sprucegum/aciduino/v2/hardware/HugoEscalpelo-3DCase-1.3inOLED-ESP32DevKitV1/img/12-X-12MM-X-7.5MM-PUSH-BUTTON.jpg

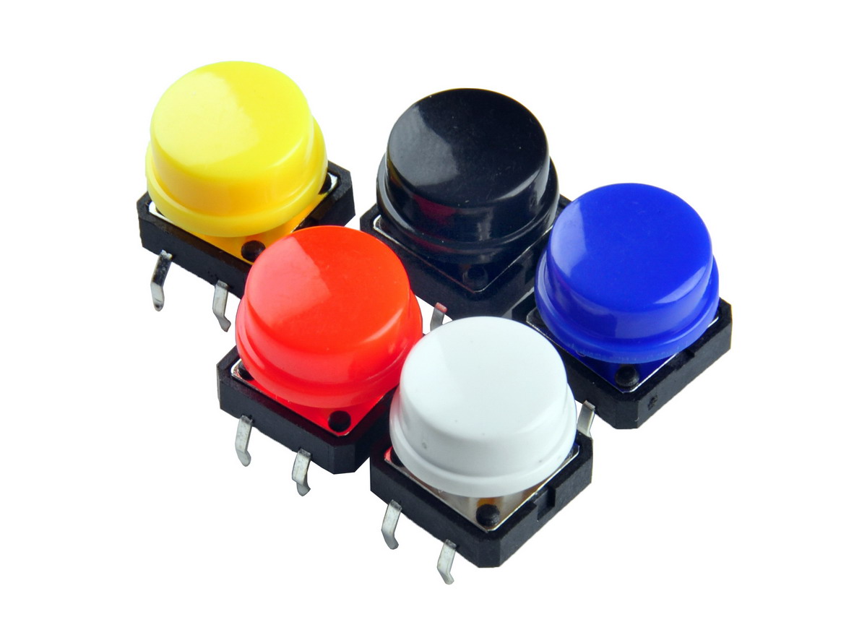
v2/hardware/HugoEscalpelo-3DCase-1.3inOLED-ESP32DevKitV1/img/12-X-12MM-X-7.5MM-PUSH-BUTTON.jpg
