sprucegum/aciduino/Renderings/---beeeeeetssss---.png

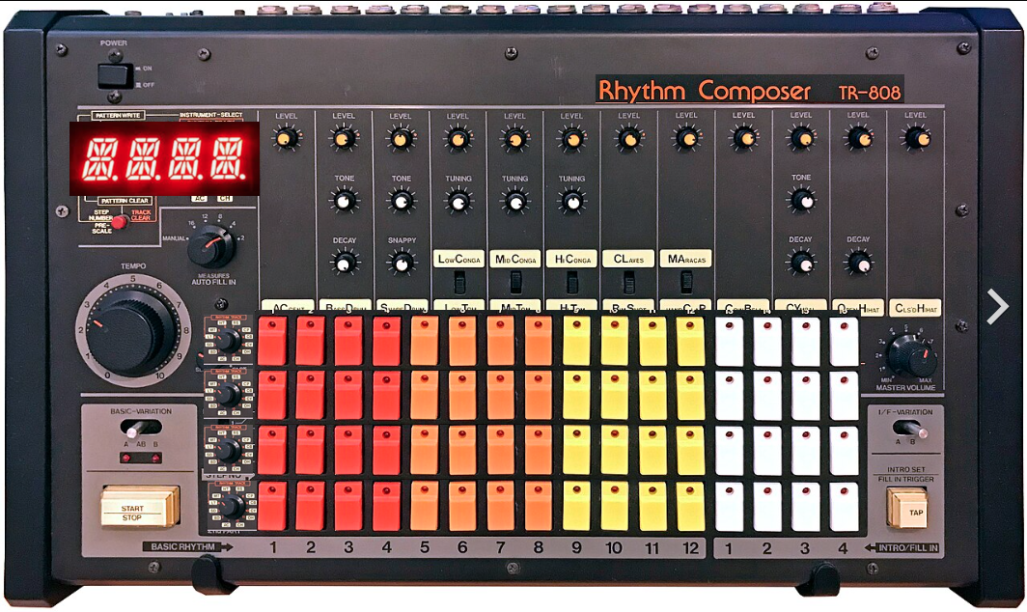
Renderings/---beeeeeetssss---.png
