sprucegum/aciduino/Renderings/DALL·E 2024-05-17 13.15.50 - A detailed diagram representing the structure and function of the AciduinoV2 project files. The diagram should include the following hierarchy and des.webp

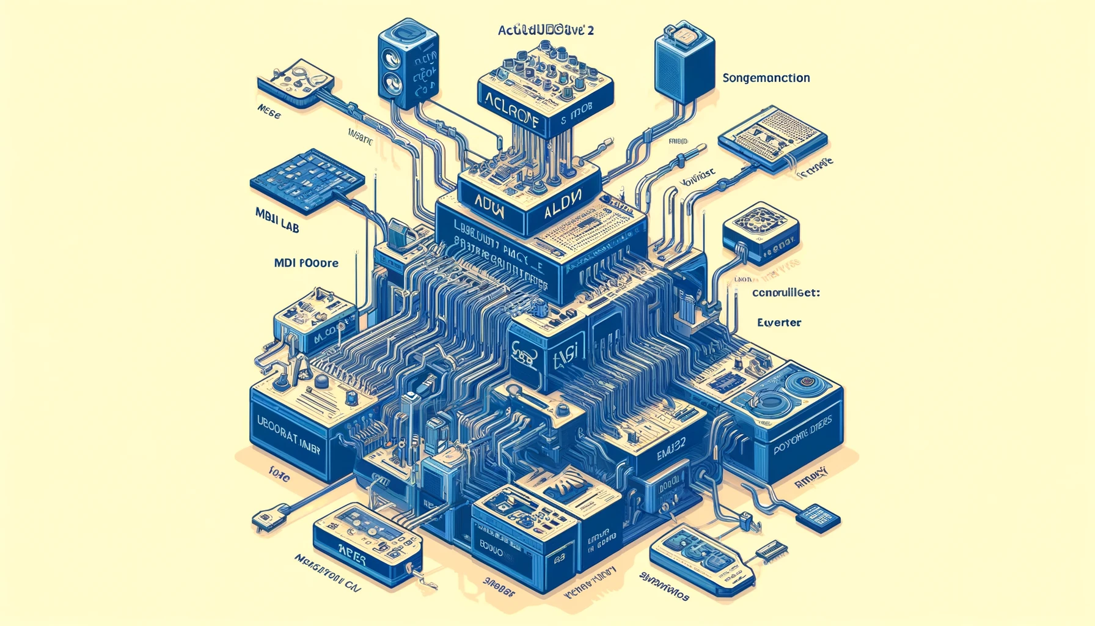
Renderings/DALL·E 2024-05-17 13.15.50 - A detailed diagram representing the structure and function of the AciduinoV2 project files. The diagram should include the following hierarchy and des.webp
