sprucegum/aciduino/Renderings/DALL·E 2024-05-17 13.17.37 - A detailed diagram representing the structure and function of the AciduinoV2 project files. The diagram should include clear, readable labels with the.webp

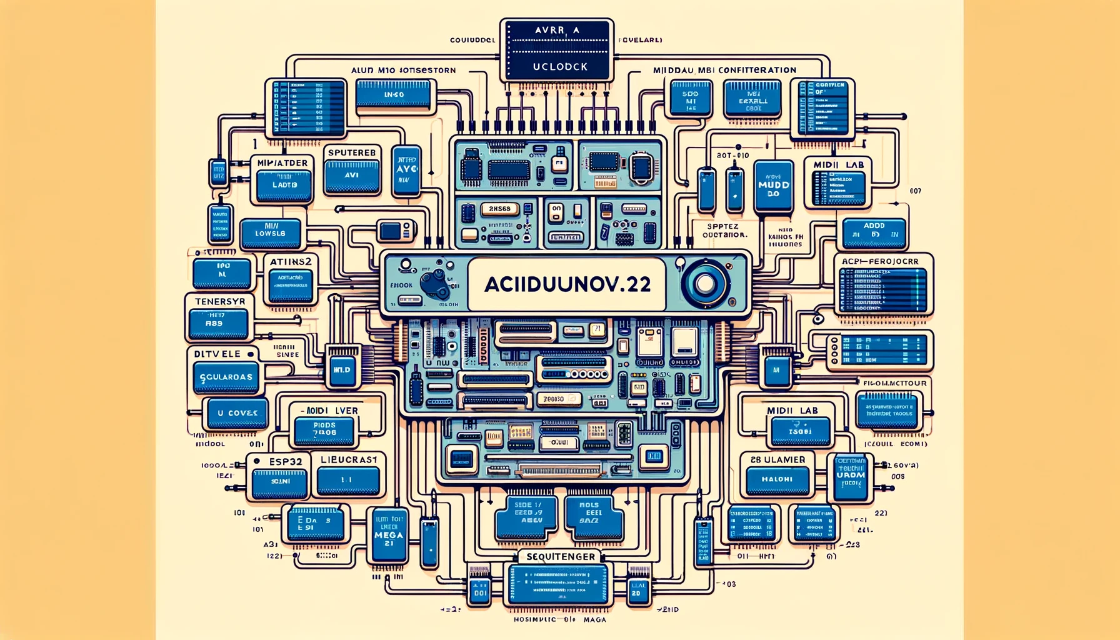
Renderings/DALL·E 2024-05-17 13.17.37 - A detailed diagram representing the structure and function of the AciduinoV2 project files. The diagram should include clear, readable labels with the.webp
