sprucegum/aciduino/Renderings/DALL·E 2024-05-17 13.19.00 - A clear and detailed diagram representing the structure and function of the AciduinoV2 project files. The diagram should include easily readable label.webp

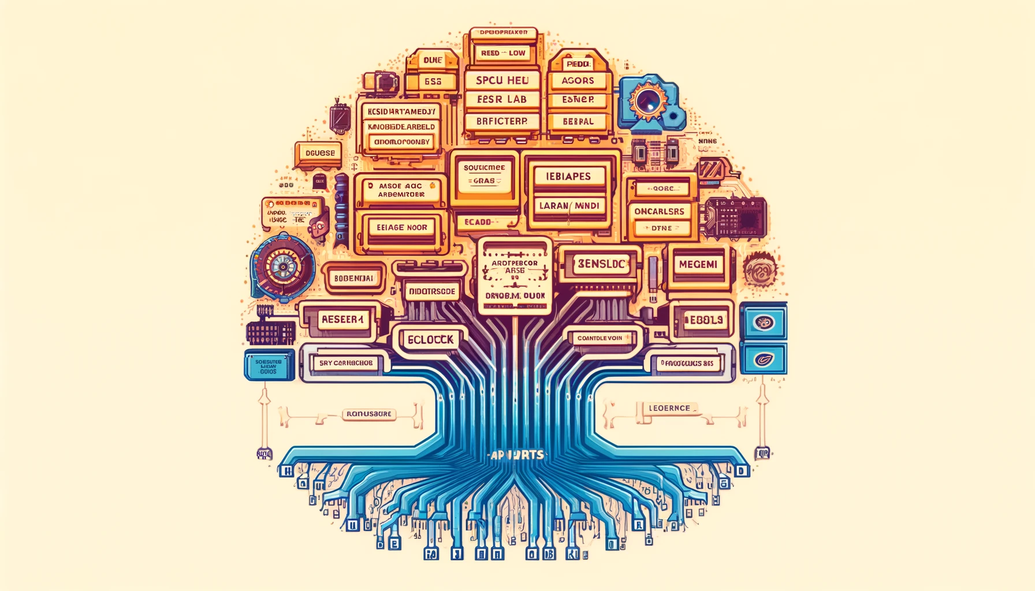
Renderings/DALL·E 2024-05-17 13.19.00 - A clear and detailed diagram representing the structure and function of the AciduinoV2 project files. The diagram should include easily readable label.webp
