sprucegum/aciduino/Renderings/DALL·E 2024-05-17 13.24.34 - A clear and detailed diagram representing the structure and function of the AciduinoV2 project files, with labels written legibly in English. The diag.webp

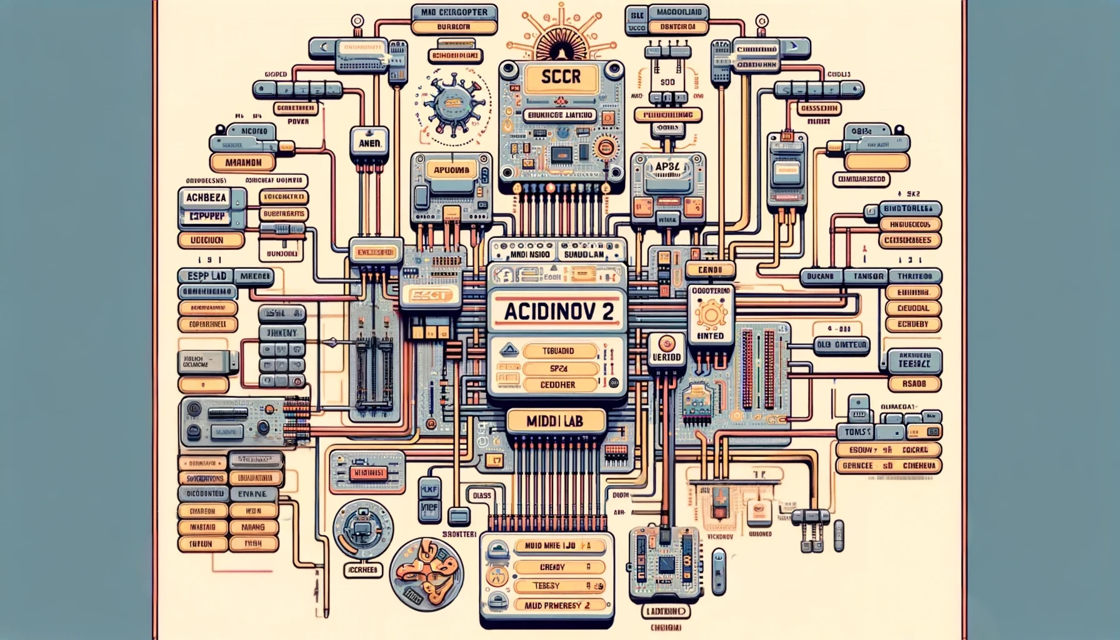
Renderings/DALL·E 2024-05-17 13.24.34 - A clear and detailed diagram representing the structure and function of the AciduinoV2 project files, with labels written legibly in English. The diag.webp
