sprucegum/aciduino/Renderings/fb15ddab-443c-424d-a31b-478fd051175f.webp

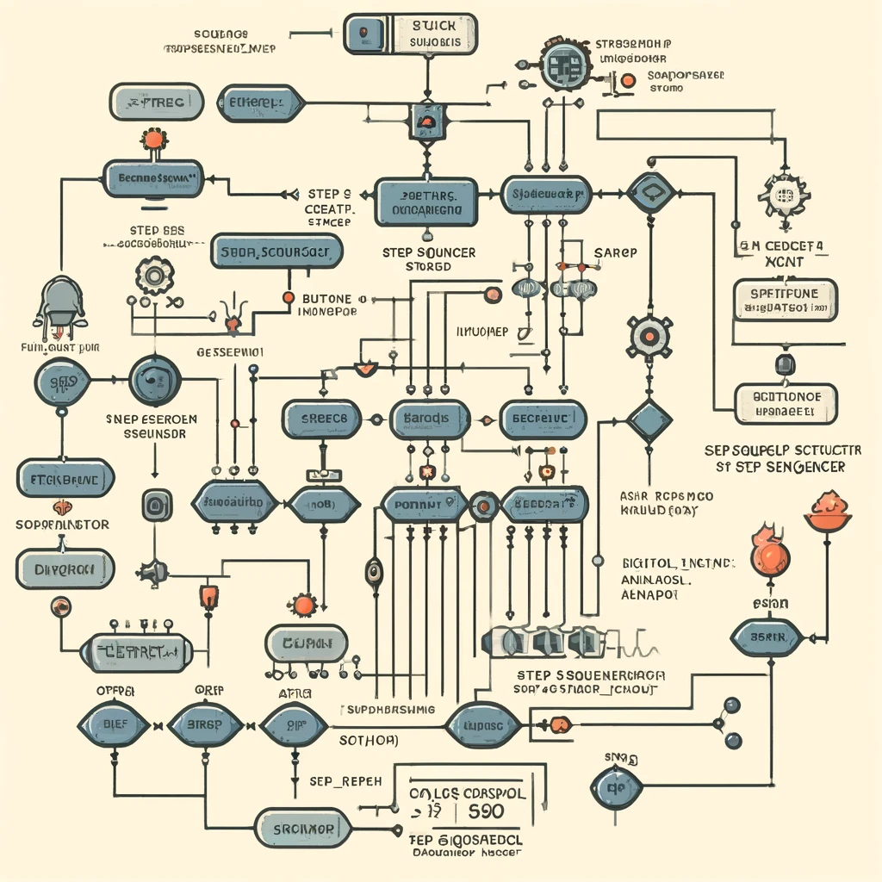
Renderings/fb15ddab-443c-424d-a31b-478fd051175f.webp
