sprucegum/aciduino/Renderings/Interface Layout_ideal.png

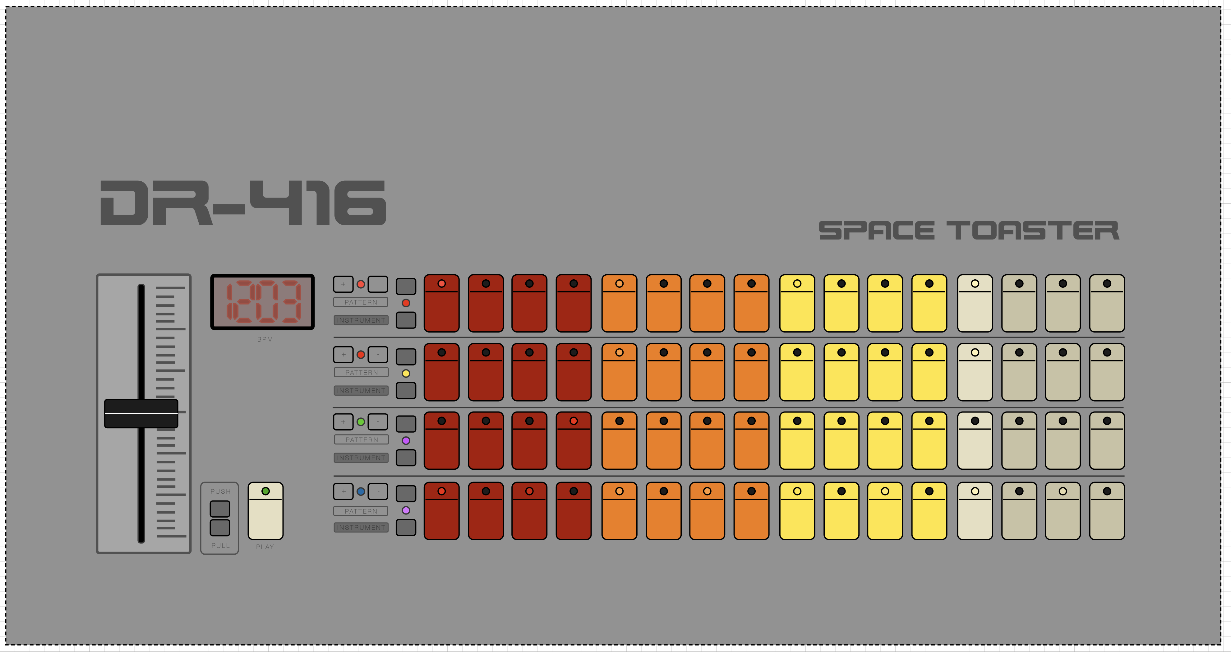
Renderings/Interface Layout_ideal.png
