sprucegum/aciduino/Renderings/Screen Shot 2024-02-01 at 5.24.22 PM.png

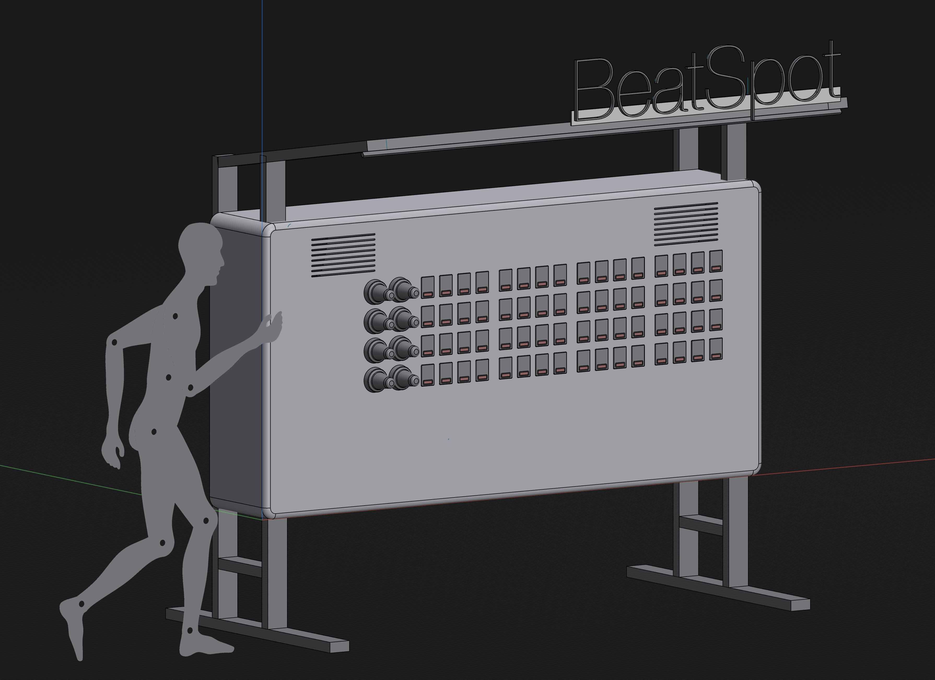
Renderings/Screen Shot 2024-02-01 at 5.24.22 PM.png
