sprucegum/aciduino/v2/hardware/HugoEscalpelo-3DCase-2.4inOLED-ESP32DevKitV1/Circuit/Schematic.png

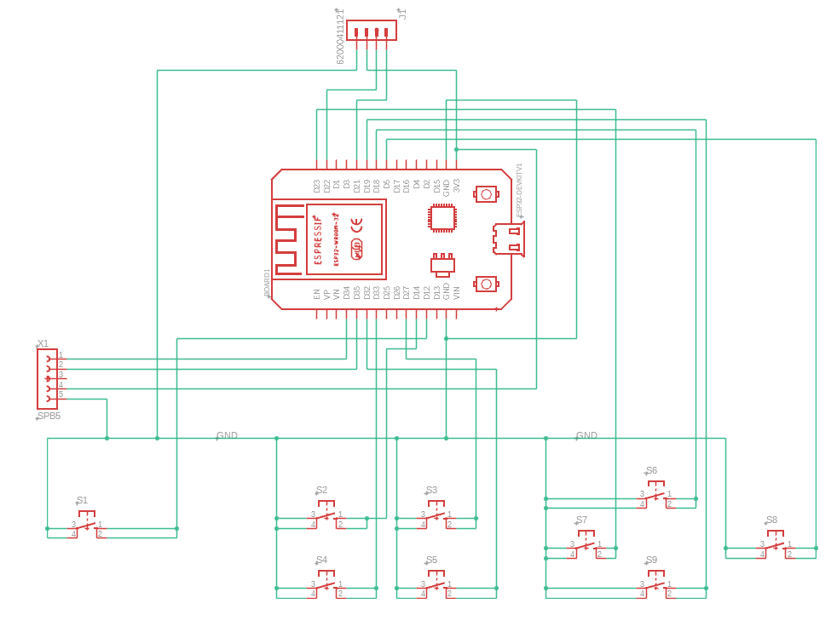
v2/hardware/HugoEscalpelo-3DCase-2.4inOLED-ESP32DevKitV1/Circuit/Schematic.png
