sprucegum/aciduino/v2/hardware/HugoEscalpelo-3DCase-1.3inOLED-ESP32DevKitV1/STEP/Top v33.step

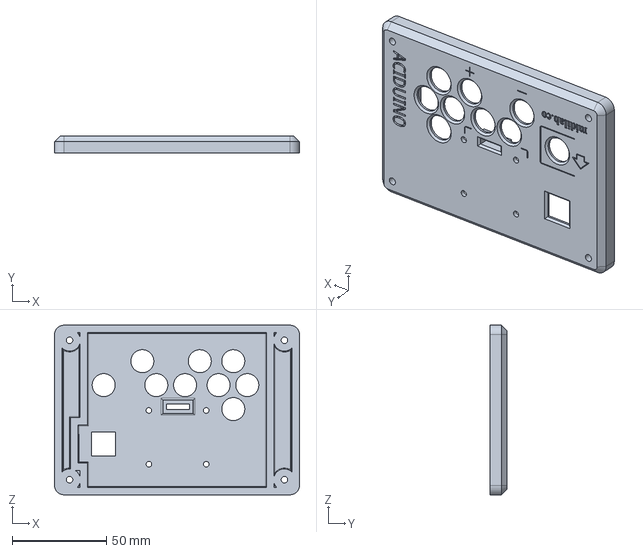
[picture p25: CAD file, 2024-06-02]
v2/hardware/HugoEscalpelo-3DCase-1.3inOLED-ESP32DevKitV1/STEP/Top v33.step
130.0 x 9.00 x 90.0 mm
