sprucegum/aciduino/v2/hardware/HugoEscalpelo-3DCase-1.3inOLED-ESP32DevKitV1/STL/Faceplate v30.stl

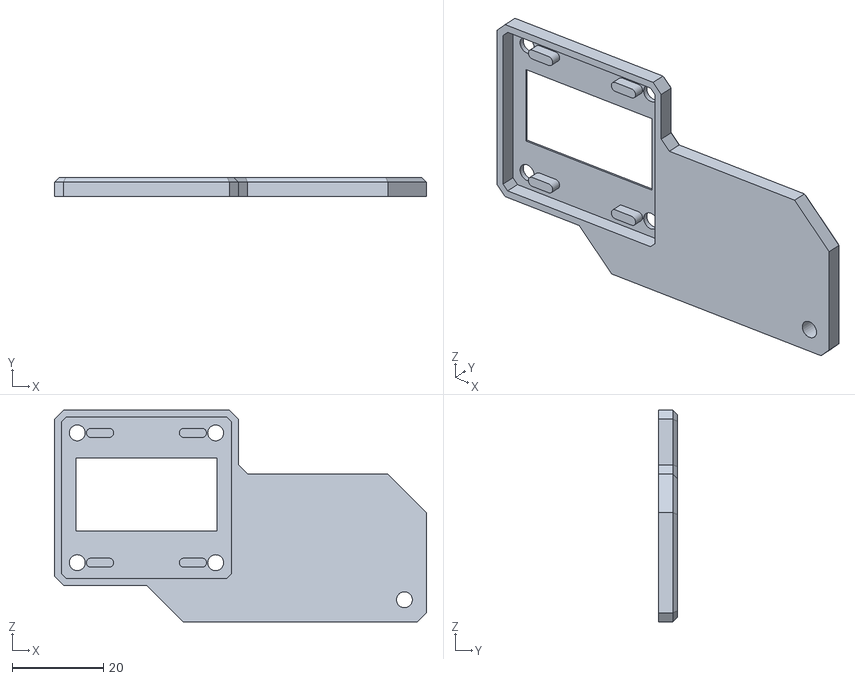
[picture p26: CAD file, 2024-06-02]
v2/hardware/HugoEscalpelo-3DCase-1.3inOLED-ESP32DevKitV1/STL/Faceplate v30.stl
81.7 x 4.10 x 46.5
