sprucegum/aciduino/v2/hardware/HugoEscalpelo-3DCase-2.4inOLED-ESP32DevKitV1/STEP/Buttons v4.step

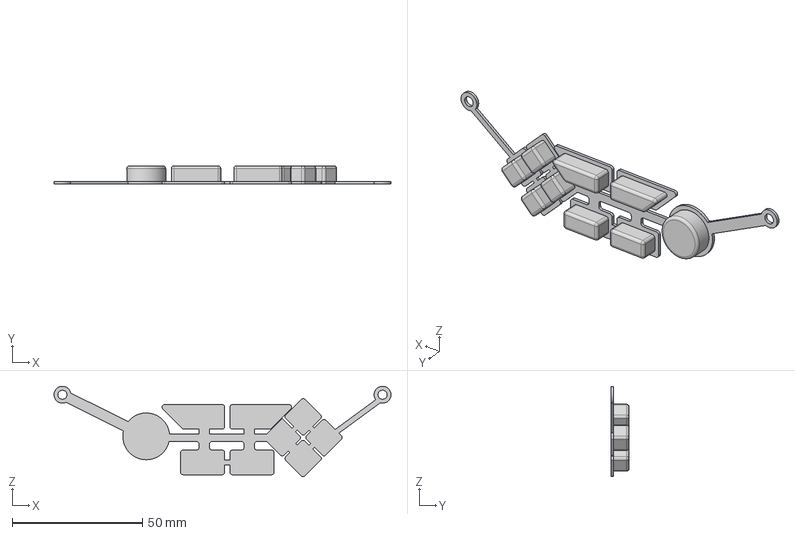
[picture p27: CAD file, 2024-06-02]
v2/hardware/HugoEscalpelo-3DCase-2.4inOLED-ESP32DevKitV1/STEP/Buttons v4.step
129.5 x 7.00 x 34.7 mm
