sprucegum/aciduino/v2/hardware/HugoEscalpelo-3DCase-1.3inOLED-ESP32DevKitV1/STEP/Wheel v3.step

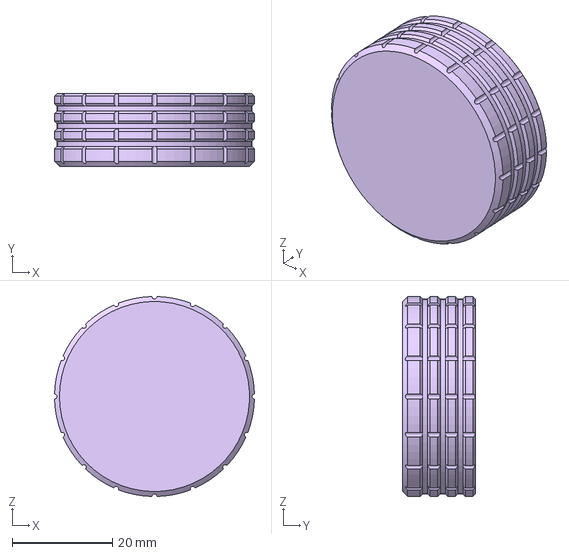
[picture p28: CAD file, 2024-06-02]
v2/hardware/HugoEscalpelo-3DCase-1.3inOLED-ESP32DevKitV1/STEP/Wheel v3.step
40.0 x 14.5 x 40.0 mm
