sprucegum/aciduino/v2/hardware/HugoEscalpelo-3DCase-1.3inOLED-ESP32DevKitV1/STL/Faceplate-AudiomaquinasLogo v32.stl

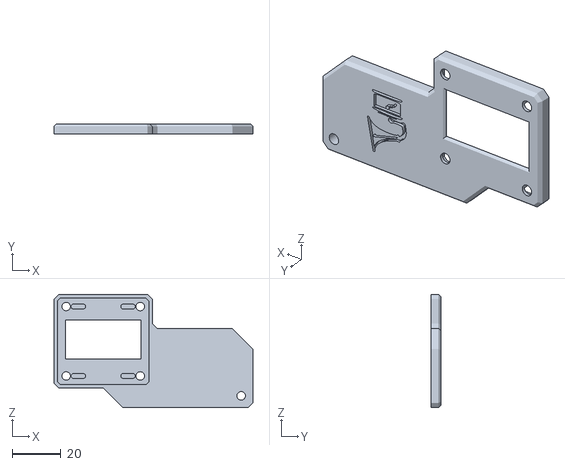
[picture p29: CAD file, 2024-06-02]
v2/hardware/HugoEscalpelo-3DCase-1.3inOLED-ESP32DevKitV1/STL/Faceplate-AudiomaquinasLogo v32.stl
81.7 x 4.10 x 46.5
