sprucegum/aciduino/v2/hardware/HugoEscalpelo-3DCase-2.4inOLED-ESP32DevKitV1/STEP/Wheel v5.step

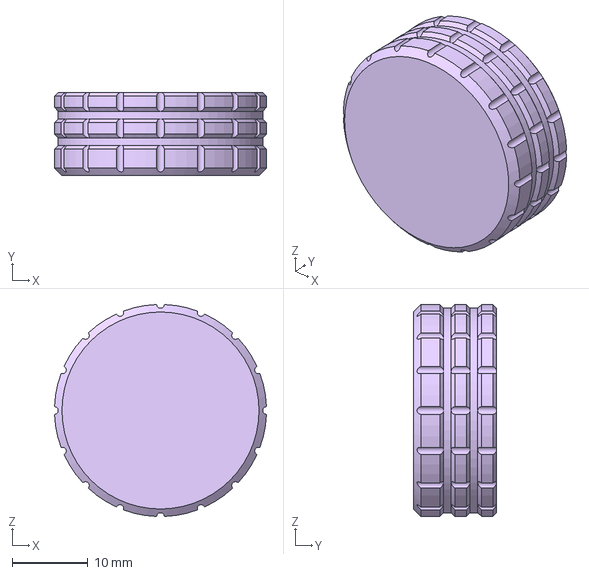
[picture p30: CAD file, 2024-06-02]
v2/hardware/HugoEscalpelo-3DCase-2.4inOLED-ESP32DevKitV1/STEP/Wheel v5.step
28.0 x 11.0 x 28.0 mm
