sprucegum/aciduino/v2/hardware/HugoEscalpelo-3DCase-1.3inOLED-ESP32DevKitV1/STEP/Base v18.step

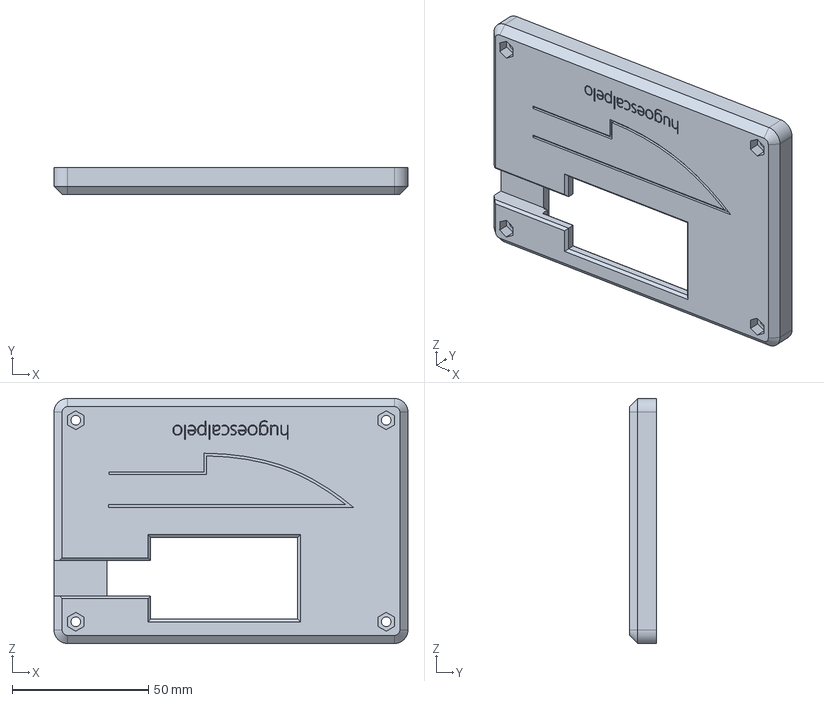
[picture p31: CAD file, 2024-06-02]
v2/hardware/HugoEscalpelo-3DCase-1.3inOLED-ESP32DevKitV1/STEP/Base v18.step
130.0 x 10.0 x 90.0 mm
