sprucegum/aciduino/v2/hardware/HugoEscalpelo-3DCase-2.4inOLED-ESP32DevKitV1/STEP/Top v11.step

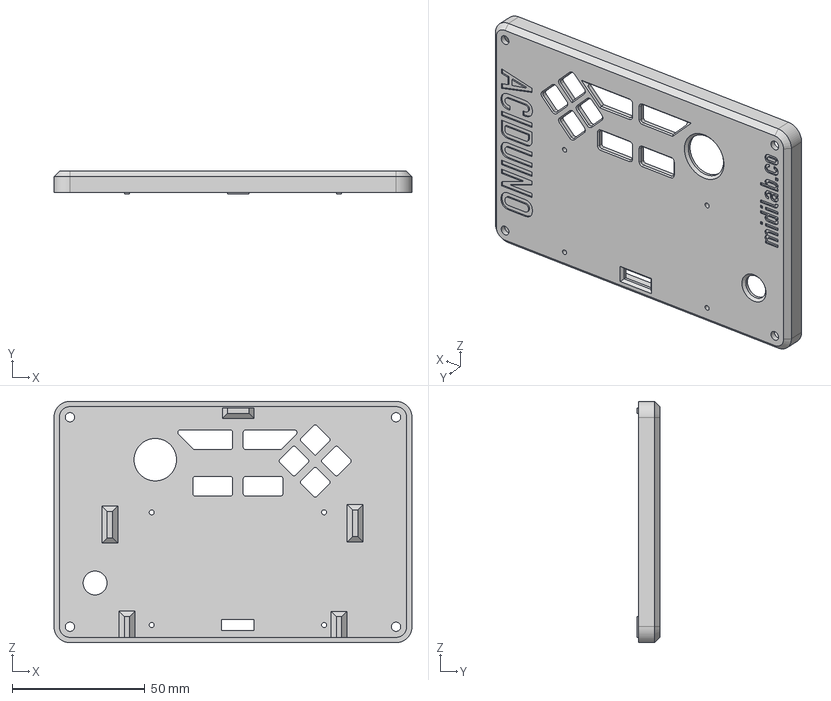
[picture p32: CAD file, 2024-06-02]
v2/hardware/HugoEscalpelo-3DCase-2.4inOLED-ESP32DevKitV1/STEP/Top v11.step
135.0 x 8.50 x 91.0 mm
