sprucegum/aciduino/v2/hardware/HugoEscalpelo-3DCase-2.4inOLED-ESP32DevKitV1/STEP/Separator v1.step

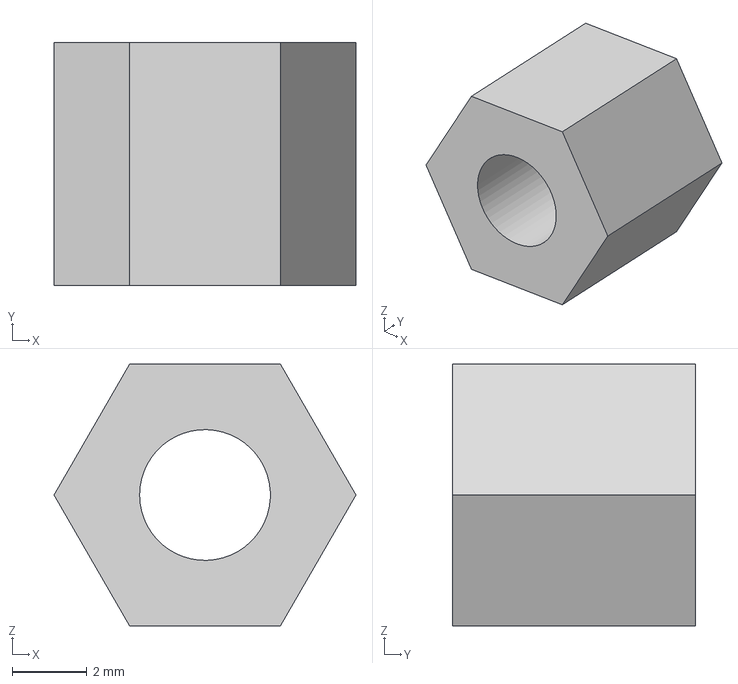
[picture p33: CAD file, 2024-06-02]
v2/hardware/HugoEscalpelo-3DCase-2.4inOLED-ESP32DevKitV1/STEP/Separator v1.step
8.08 x 6.50 x 7.00 mm
