sprucegum/aciduino/v2/hardware/HugoEscalpelo-3DCase-2.4inOLED-ESP32DevKitV1/STEP/Base v7.step

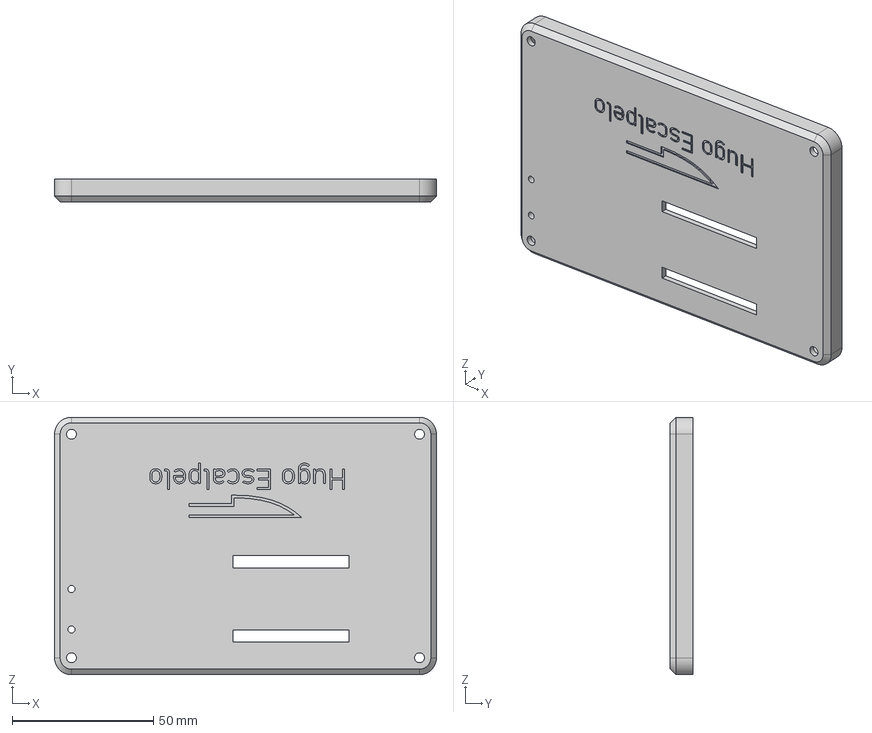
[picture p34: CAD file, 2024-06-02]
v2/hardware/HugoEscalpelo-3DCase-2.4inOLED-ESP32DevKitV1/STEP/Base v7.step
135.0 x 8.00 x 91.0 mm
