sprucegum/aciduino/(list of files, cad)

Other CAD files:
v2/hardware/HugoEscalpelo-3DCase-1.3inOLED-ESP32DevKitV1/STEP/Faceplate Audiomaquinas v32.step
v2/hardware/HugoEscalpelo-3DCase-1.3inOLED-ESP32DevKitV1/STEP/Faceplate v32.step
v2/hardware/HugoEscalpelo-3DCase-1.3inOLED-ESP32DevKitV1/STL/Base v18.stl
v2/hardware/HugoEscalpelo-3DCase-1.3inOLED-ESP32DevKitV1/STL/Top v33.stl
v2/hardware/HugoEscalpelo-3DCase-1.3inOLED-ESP32DevKitV1/STL/Wheel v3.stl
v2/hardware/HugoEscalpelo-3DCase-2.4inOLED-ESP32DevKitV1/STL/Base v7.stl
v2/hardware/HugoEscalpelo-3DCase-2.4inOLED-ESP32DevKitV1/STL/Buttons v4.stl
v2/hardware/HugoEscalpelo-3DCase-2.4inOLED-ESP32DevKitV1/STL/Separator v1.stl
v2/hardware/HugoEscalpelo-3DCase-2.4inOLED-ESP32DevKitV1/STL/Top v11.stl
v2/hardware/HugoEscalpelo-3DCase-2.4inOLED-ESP32DevKitV1/STL/Wheel v5.stl
