sprucegum/aciduino/v2/AciduinoV2/AciduinoV2.ino

/*!
 *  @file       AciduinoV2.ino
 *  Project     Aciduino V2 BeatPort
 *  @brief      Roland 303 and 808 step sequencer clone
 *  @version    2.1.0
 *  @author     Romulo Silva
 *  @date       11/01/22
 *  @license    MIT - (c) 2022 - Romulo Silva - contact@midilab.co
 *
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
 * THE SOFTWARE IS PROVIDED "AS IS", WITHOUT WARRANTY OF ANY KIND, EXPRESS
 * OR IMPLIED, INCLUDING BUT NOT LIMITED TO THE WARRANTIES OF MERCHANTABILITY,
 * FITNESS FOR A PARTICULAR PURPOSE AND NONINFRINGEMENT. IN NO EVENT SHALL THE
 * AUTHORS OR COPYRIGHT HOLDERS BE LIABLE FOR ANY CLAIM, DAMAGES OR OTHER
 * LIABILITY, WHETHER IN AN ACTION OF CONTRACT, TORT OR OTHERWISE, ARISING
 * FROM, OUT OF OR IN CONNECTION WITH THE SOFTWARE OR THE USE OR OTHER
 * DEALINGS IN THE SOFTWARE. 
 */
#include <Arduino.h>

//
// Aciduino
//
#include "src/aciduino.hpp"

//
// Select your platform port
//
//#include "src/ports/avr/mega.h"
//#include "src/ports/teensy/protoboard.h"
//#include "src/ports/esp32/wroom.h"
//include "src/ports/esp32/wroom-ext1.h"
//#include "src/ports/teensy/uone.h"
#include "src/ports/avr/midilab_mega.h"
//#include "src/ports/avr/mega_raw_ui.h"

void setup() {
  // inits all hardware setup for the selected port
  initPort();
}

void loop() {
  aciduino.run();
}
