sprucegum/aciduino/(commit log)

2024-05-20 Added images
    CAD drawings, Interface outline and some funny pics
2024-06-02 3D printed Case 1.3in added
    [Aciduino_Schematic_v6.sch, Base v18.step, Base v18.stl, Faceplate Audiomaquinas v32.step, Faceplate v30.stl, Faceplate v32.step, Faceplate-AudiomaquinasLogo v32.stl, Top v33.step]
2024-06-02 3D printed Case 2.4 in 128x64 OLED Version
    [Aciduino_Schematic_v6.sch, Base v7.step, Base v7.stl, Buttons v4.step, Buttons v4.stl, Separator v1.step, Separator v1.stl, Top v11.step]
